jclements3/babyharp12/babyharp12.scad

// babyharp12.scad - 3D assembly of the BabyHarp 12 prototype.
// Auto-generated by tools/make_scad.py from frame_data.py.
// Open in OpenSCAD (F5 preview / F6 render).

$fn = 64;

// ---------- Profile polygons (mm) ----------
NECK_OUTLINE = [[352.544,277.341], [355.327,286.218], [357.497,295.188], [359.028,304.167], [359.892,313.073], [360.064,321.823], [359.515,330.332], [358.221,338.517], [356.153,346.296], [353.285,353.586], [349.591,360.302], [345.044,366.362], [339.617,371.682], [333.283,376.180], [326.016,379.772], [317.790,382.374], [308.577,383.904], [298.350,384.278], [287.084,383.413], [283.486,382.844], [279.948,382.084], [276.461,381.157], [273.019,380.087], [269.615,378.896], [266.241,377.608], [262.890,376.248], [259.554,374.838], [256.227,373.403], [252.902,371.966], [249.570,370.550], [246.225,369.180], [242.859,367.879], [239.466,366.670], [236.038,365.577], [232.568,364.625], [229.048,363.835], [225.471,363.233], [223.113,362.947], [220.760,362.745], [218.413,362.627], [216.075,362.594], [213.745,362.645], [211.427,362.783], [209.122,363.006], [206.831,363.315], [204.556,363.712], [202.298,364.195], [200.059,364.765], [197.841,365.424], [195.645,366.171], [193.472,367.006], [191.324,367.930], [189.203,368.944], [187.111,370.048], [185.048,371.242], [176.640,376.950], [169.115,383.231], [162.307,389.984], [156.052,397.111], [150.186,404.511], [144.546,412.084], [138.965,419.732], [133.281,427.353], [127.328,434.849], [120.944,442.120], [113.962,449.066], [106.219,455.588], [97.551,461.585], [87.793,466.958], [76.781,471.607], [64.351,475.432], [50.339,478.335], [34.579,480.215], [33.421,480.318], [32.152,480.443], [30.788,480.580], [29.345,480.717], [27.841,480.841], [26.291,480.943], [24.712,481.010], [23.121,481.031], [21.534,480.994], [19.968,480.888], [18.440,480.702], [16.965,480.424], [15.561,480.042], [14.243,479.545], [13.029,478.922], [11.936,478.161], [10.978,477.250], [10.174,476.179], [9.436,474.523], [9.024,472.502], [8.905,470.161], [9.047,467.541], [9.416,464.687], [9.980,461.643], [10.705,458.450], [11.559,455.153], [12.509,451.795], [13.522,448.420], [14.565,445.070], [15.606,441.789], [16.611,438.620], [17.547,435.607], [18.382,432.794], [19.082,430.222], [19.615,427.937], [19.949,425.980], [20.279,423.188], [20.574,420.371], [20.832,417.535], [21.052,414.680], [21.232,411.812], [21.370,408.932], [21.464,406.043], [21.514,403.149], [21.518,400.253], [21.473,397.358], [21.378,394.466], [21.233,391.581], [21.034,388.706], [20.781,385.844], [20.472,382.998], [20.105,380.170], [19.679,377.365], [19.192,374.584], [19.164,374.458], [19.117,374.272], [19.055,374.035], [18.980,373.753], [18.895,373.435], [18.804,373.087], [18.710,372.718], [18.615,372.334], [18.522,371.943], [18.435,371.553], [18.357,371.171], [18.291,370.804], [18.239,370.461], [18.205,370.147], [18.192,369.872], [18.203,369.643], [18.241,369.466], [18.309,369.350], [18.564,369.226], [18.991,369.175], [19.568,369.188], [20.275,369.258], [21.090,369.377], [21.993,369.538], [22.963,369.732], [23.979,369.952], [25.020,370.189], [26.065,370.438], [27.092,370.689], [28.082,370.935], [29.014,371.168], [29.865,371.381], [30.616,371.565], [31.246,371.714], [31.733,371.819], [32.057,371.872], [35.627,372.228], [39.229,372.531], [42.857,372.776], [46.507,372.960], [50.173,373.077], [53.851,373.124], [57.535,373.096], [61.221,372.988], [64.903,372.797], [68.577,372.517], [72.238,372.145], [75.881,371.676], [79.500,371.105], [83.091,370.429], [86.649,369.642], [90.169,368.740], [93.646,367.719], [97.075,366.575], [102.552,364.391], [107.816,361.840], [112.895,358.973], [117.819,355.841], [122.617,352.494], [127.319,348.983], [131.952,345.357], [136.546,341.667], [141.130,337.963], [145.734,334.297], [150.386,330.718], [155.116,327.276], [159.952,324.023], [164.924,321.008], [170.061,318.282], [175.392,315.895], [180.945,313.898], [186.751,312.341], [195.504,310.675], [203.479,309.708], [210.747,309.373], [217.383,309.606], [223.459,310.339], [229.048,311.508], [234.224,313.047], [239.059,314.890], [243.627,316.970], [248.000,319.223], [252.251,321.582], [256.455,323.982], [260.683,326.356], [265.009,328.640], [269.505,330.767], [274.246,332.671], [279.303,334.286], [284.751,335.548], [288.616,336.050], [292.190,336.075], [295.472,335.655], [298.458,334.822], [301.146,333.611], [303.533,332.052], [305.618,330.180], [307.398,328.027], [308.871,325.624], [310.033,323.006], [310.884,320.205], [311.420,317.253], [311.638,314.184], [311.538,311.029], [311.116,307.822], [310.369,304.596], [309.297,301.382], [307.895,298.215]];

COLUMN_OUTLINE = [[90.390,368.593], [87.723,369.231], [85.046,369.813], [82.361,370.341], [79.669,370.816], [76.969,371.240], [74.263,371.613], [71.551,371.939], [68.833,372.216], [66.112,372.448], [63.386,372.635], [60.657,372.779], [57.925,372.882], [55.192,372.943], [52.457,372.966], [49.721,372.951], [46.985,372.899], [44.250,372.812], [41.516,372.692], [37.114,372.456], [33.246,372.195], [29.880,371.878], [26.986,371.474], [24.531,370.952], [22.483,370.280], [20.813,369.427], [19.487,368.362], [18.474,367.055], [17.743,365.473], [17.262,363.586], [16.999,361.362], [16.924,358.770], [17.004,355.780], [17.207,352.359], [17.503,348.478], [17.860,344.103], [18.246,339.206], [20.074,322.299], [22.823,306.940], [26.407,292.962], [30.738,280.200], [35.731,268.488], [41.297,257.662], [47.350,247.555], [53.804,238.003], [60.571,228.840], [67.564,219.900], [74.696,211.019], [81.881,202.030], [89.032,192.769], [96.061,183.069], [102.882,172.767], [109.409,161.695], [115.553,149.689], [121.228,136.584], [122.936,132.162], [124.619,127.587], [126.253,122.877], [127.815,118.051], [129.282,113.125], [130.632,108.119], [131.839,103.049], [132.883,97.934], [133.739,92.791], [134.384,87.640], [134.795,82.496], [134.948,77.379], [134.822,72.306], [134.392,67.295], [133.635,62.365], [132.529,57.532], [131.050,52.815], [129.174,48.233], [128.768,47.414], [128.310,46.589], [127.806,45.759], [127.266,44.923], [126.697,44.083], [126.109,43.237], [125.508,42.388], [124.904,41.534], [124.305,40.677], [123.718,39.816], [123.152,38.952], [122.615,38.085], [122.116,37.216], [121.663,36.345], [121.264,35.472], [120.926,34.598], [120.660,33.722], [120.471,32.845], [120.378,32.007], [120.364,31.129], [120.423,30.216], [120.545,29.273], [120.724,28.307], [120.952,27.323], [121.220,26.325], [121.522,25.320], [121.848,24.314], [122.192,23.311], [122.546,22.317], [122.901,21.337], [123.251,20.377], [123.586,19.443], [123.900,18.540], [124.184,17.673], [124.431,16.848], [124.634,16.070], [124.783,15.412], [124.931,14.736], [125.080,14.049], [125.237,13.358], [125.405,12.669], [125.589,11.990], [125.794,11.326], [126.025,10.685], [126.286,10.073], [126.581,9.497], [126.916,8.964], [127.295,8.481], [127.722,8.053], [128.203,7.688], [128.741,7.392], [129.343,7.173], [130.011,7.036], [130.751,6.989], [130.751,6.989], [130.751,7.116], [140.336,7.116], [90.390,368.593], [89.703,366.032], [89.092,363.431], [88.552,360.795], [88.079,358.129], [87.671,355.436], [87.324,352.722], [87.034,349.991], [86.798,347.247], [86.612,344.495], [86.472,341.739], [86.375,338.984], [86.318,336.235], [86.297,333.495], [86.308,330.769], [86.348,328.062], [86.414,325.378], [86.501,322.722], [86.606,320.098], [87.429,308.685], [88.841,298.065], [90.803,288.152], [93.277,278.862], [96.221,270.111], [99.596,261.815], [103.364,253.889], [107.484,246.250], [111.918,238.812], [116.624,231.492], [121.565,224.204], [126.700,216.866], [131.990,209.393], [137.396,201.699], [142.877,193.702], [148.395,185.317], [153.909,176.458], [159.381,167.044], [161.632,162.871], [163.740,158.673], [165.717,154.451], [167.575,150.206], [169.326,145.938], [170.983,141.651], [172.556,137.343], [174.059,133.018], [175.502,128.676], [176.899,124.318], [178.260,119.945], [179.599,115.559], [180.927,111.161], [182.256,106.753], [183.598,102.335], [184.965,97.908], [186.369,93.474], [187.823,89.035]];

SPACER_OUTLINE = [[270.064,282.341], [360.064,282.341], [360.064,476.031], [270.064,476.031]];

SOUNDBOX_OUTLINE = [[306.697,295.062], [140.778,7.494], [140.526,7.116], [267.093,7.116], [351.408,274.125], [306.697,295.062]];

JOINT_OUTLINE = [[306.444,295.125], [306.634,295.503], [306.823,295.818], [306.949,296.197], [307.138,296.575], [307.327,296.953], [307.517,297.395], [307.706,297.773], [307.895,298.215], [352.544,277.341], [351.976,275.764], [351.408,274.125], [306.444,295.125]];


// ---------- Layer thicknesses ----------
PLY            = 6.0;
NECK_THICKNESS = 30.0;   // 2 cheeks + 3 spacers
SBX_INTERIOR   = 48.0;
SBX_WIDTH      = 60.0;   // soundbox cheek-to-cheek
SOUNDBOARD_T   = 3.0;
BACK_T         = 3.0;

// ---------- Z positions ----------
Z_BACK_CHEEK = -15.000;
Z_SPACER0 = -9.000;
Z_SPACER1 = -3.000;
Z_SPACER2 = 3.000;
Z_FRONT_CHEEK = 9.000;
Z_SBX_BACK_CHEEK = -30.000;
Z_SBX_FRONT_CHEEK = 24.000;
Z_BACK_PANEL = -33.000;

// ---------- Colors ----------
PLY_COLOR    = [0.82, 0.71, 0.55];     // Baltic birch
TONEWOOD     = [0.93, 0.84, 0.70];     // Sitka spruce
BACK_COLOR   = [0.65, 0.50, 0.35];     // back panel (birch stained)
STRING_COLOR = [0.20, 0.20, 0.20];

// ---------- Soundboard endpoints (mm) ----------
C8 = [187.823, 89.035];
S0 = [306.697, 295.062];
SB_LEN = 237.861;

// ---------- Sound hole positions ----------
SH1 = [227.447, 157.710];
SH2 = [267.072, 226.386];
SH_LONG  = 40;
SH_SHORT = 22;

// ---------- Modules ----------

module ply_layer(profile, z) {
    color(PLY_COLOR)
        translate([0, 0, z])
            linear_extrude(height = PLY)
                polygon(profile);
}

module neck_back()    { ply_layer(NECK_OUTLINE, Z_BACK_CHEEK); }
module neck_front()   { ply_layer(NECK_OUTLINE, Z_FRONT_CHEEK); }
module neck_spacer(z) { ply_layer(SPACER_OUTLINE, z); }

module column_body(z) { ply_layer(COLUMN_OUTLINE, z); }
// Column supports = same column shape but only the top portion overlapping
// the neck-attach area. Approximated by intersecting with a "top region" box.
module column_support(z) {
    intersection() {
        ply_layer(COLUMN_OUTLINE, z);
        // Top region: rough bounding box from neck outline overlap
        translate([0, 200, z - 1])
            cube([1000, 800, PLY + 2]);
    }
}

module soundbox_cheek(z) { ply_layer(SOUNDBOX_OUTLINE, z); }
module joint(z)          { ply_layer(JOINT_OUTLINE, z); }

// Soundboard: a flat strip extruded along the soundboard line (C8 -> S0),
// rotated so the long axis lies between them, set 3 mm thick along its
// surface normal. Placed between the soundbox cheeks (Z centered on 0).
module soundboard() {
    sb_angle_rad = atan2(S0[1] - C8[1], S0[0] - C8[0]);
    sb_angle_deg = sb_angle_rad;
    color(TONEWOOD)
        translate([C8[0], C8[1], -SBX_INTERIOR/2])
            rotate([0, 0, sb_angle_deg])
                translate([0, -25, 0])   // strip width 50 mm
                    cube([SB_LEN, 50, SOUNDBOARD_T]);
}

// Back panel with sound holes. Lies in the X-Y plane at Z = Z_BACK_PANEL.
module back_panel() {
    color(BACK_COLOR)
        translate([0, 0, Z_BACK_PANEL])
            linear_extrude(BACK_T)
                difference() {
                    polygon(SOUNDBOX_OUTLINE);
                    translate(SH1) scale([SH_SHORT/SH_LONG, 1, 1]) circle(d = SH_LONG);
                    translate(SH2) scale([SH_SHORT/SH_LONG, 1, 1]) circle(d = SH_LONG);
                }
}

// ---------- Assembly ----------
module babyharp() {
    // Neck stack (right cheek back, 3 spacer layers, left cheek front)
    neck_back();
    neck_spacer(Z_SPACER0);
    neck_spacer(Z_SPACER1);
    neck_spacer(Z_SPACER2);
    neck_front();

    // Column stack (3-layer body matches the spacer Zs; 2 supports flank it)
    column_body(Z_SPACER0);
    column_body(Z_SPACER1);
    column_body(Z_SPACER2);
    column_support(Z_BACK_CHEEK);
    column_support(Z_FRONT_CHEEK);

    // Joint piece — single 6 mm layer between the cheeks
    joint(Z_SPACER1);

    // Soundbox
    soundbox_cheek(Z_SBX_BACK_CHEEK);
    soundbox_cheek(Z_SBX_FRONT_CHEEK);
    back_panel();
    soundboard();
}

babyharp();
