jclements3/babyharp12/(commit log)

2026-05-20 Refactor to use svgwrite with named groups; add separate frame source file
2026-05-20 Add neck spacer, smooth C3 corner, exact column/neck mesh
    - Column top edge now traces the exact neck Bezier (de Casteljau split
    at C0) instead of a polyline, so the shared boundary is pixel-perfect.
    - Force N4 to be a true sharp 90° corner by overriding the cp2/cp1
    handles around it (incoming straight down, outgoing straight right);
    separately make C3 G1-continuous on the column outline (exit handle
    aligned with the input trajectory).
    - Drop C4 as a node; merge C3->C4->next into one sweeping Bezier with
    an extended C3 exit handle to eliminate the localized bulge.
    - Renumber COLUMN_NODES to C0-C9 (C0..C3 sit on the shared neck/column
    boundary, C4..C9 trace the rest of the column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
2026-05-20 Remove harp.md (full 47-string spec; out of scope for this repo)
    This repo is the 12-string babyharp prototype. The full 47-string
    design spec was reference material that's no longer used here.
    Rewrite CLAUDE.md to focus on the 12-string scope.
2026-05-20 Refactor frame data + clean SVG output + add front neck layer
    - Move Schneider Bezier fits and frame polylines into a generated
    frame_data.py, populated by tools/extract_frame_data.py. babyharp.py
    no longer reads babyharp_frame.svg or imports bezierfit at runtime
    (numpy and svgwrite dependencies also dropped).
    - bezierfit.py kept in repo as the offline tool that backs the
    extract_frame_data.py script.
    - Replace svgwrite with a hand-formatted emitter: one logical XML
    element per line, no nested transform groups (the inner-coord
    matrix(2,0,0,-2,0,930.78)·scale(0.1) is baked into each coordinate
    so the file is directly readable in a text editor).
    - Add front neck layer ("neck_fro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
2026-05-20 Enforce exact 13mm air gap; separate eyelet hole from string start
    - Replace equal eyelet spacing with iterative variable spacing so the
    perpendicular air gap between adjacent string ODs is exactly 13mm
    (was drifting +0.04 to +0.44mm). SB_step = (13 + avg_d)/sin(rake)
    per pair; converges in a few iterations because diameter depends
    on vibrating length depends on eyelet position.
    - BASS_BOUNDARY_MM = 16mm anchors C5 at a fixed distance from C8 along
    the soundboard; treble boundary (G6 -> S0) absorbs whatever length
    remains (currently ~23mm).
    - Split StringSpec.eyelet into eyelet (string CENTERLINE start, where
    the string path begins) and eyelet_hole (eyelet CIRCLE center,
    shif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
2026-05-20 Add BOM.md with strings, eyelets, bridge pins, tuners
    Initial BOM seed. Candidate parts:
    - Roosebeck Bridge Pins (B08JCP7CYQ) — 2 packs of 6 = 12 pins
    - Guyker Locking Tuners (UPC 718893958574) — 2 packs of 6 = 12 tuners
    (3L + 3R per pack matches the odd-left / even-right cheek split)
    Flagged the Guyker 10mm peg hole as larger than the current
    BIG_CIRCLE_DIA_MM = 7.0 anchor; that constant pins the whole drawing
    scale so it can't just be bumped without rescaling.
2026-05-20 BOM: add Baltic birch plywood spec and frame layer breakdown
    6 mm (1/4") Baltic birch for all laminated frame parts. The 30 mm
    neck thickness = 5 layers (2 cheeks + 3 spacers). Column matches at
    the neck-attach area (2 supports + 3 body layers) for continuous flat
    exterior surfaces and an 18 mm interior gap that houses the bridge-
    pin shafts and Guyker tuner string posts.
    Total Baltic birch parts: 13 (plus soundboard tonewood TBD).
    Includes assembly notes.
2026-05-20 BOM: specify soundboard tonewood (Sitka spruce, quartersawn, 3mm)
    Sitka chosen for stiffness/weight, availability, and broad luthier-
    supplier coverage (StewMac, LMI, NDB). Quartersawn for stability
    along the string-pull axis. 3 mm hits the typical small-harp range
    (2.5-3.5 mm) - thin enough to respond at our 8-100 N tensions,
    thick enough to resist warping. Western red cedar, Engelmann, and
    Adirondack listed as drop-in alternatives.
2026-05-20 BOM: add bracing, soundbox internals, and sound-hole design
    Soundboard bracing:
    - 1x maple stringband (carries the ~55 kg string pull)
    - 2x spruce fan braces (stiffen against drum mode without killing
    the lower-bout vibration area)
    - 2x spruce end caps reinforcing the slot tabs
    Soundbox internals:
    - back panel, bass/treble blocks, kerfed linings, optional transverse
    braces
    Sound holes: two 40x22 mm ovals on the back, centerline-aligned,
    giving ~1380 mm^2 total open area. Helmholtz tuning:
    f = (c/2pi) * sqrt(A / (V * L_eff)) ~= 290 Hz
    which is roughly an octave below the bass string (C5 = 523 Hz),
    landing the Helmholtz peak where the small box most needs bass help.
    Includes rationale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
2026-05-20 Add OpenSCAD 3D model and generator
    tools/make_scad.py reads frame_data.py (polylines + Bezier fits +
    short d-strings), samples each profile into polygons, and writes
    babyharp12.scad — a self-contained OpenSCAD assembly of the laminated
    parts in their BOM-driven Z positions.
    Includes:
    - 2 neck cheeks + 3 neck-spacer layers (5x6mm = 30mm total)
    - 2 column supports + 3 column-body layers (matching neck thickness)
    - 1 joint piece between cheeks
    - 2 soundbox cheeks
    - soundboard strip extruded along the C8->S0 axis
    - back panel with two 40x22mm oval sound holes per the BOM
    Helmholtz tuning (resonance ~290 Hz)
    Open babyharp12.scad in OpenSCAD (F5 preview / F6 render); the SVG
    inner coords ar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
    [babyharp12.scad]
